sazon777z/RaceMetry/CODE_REVIEW.md

# Code review проекта RaceMetry / DRAGon

Дата ревью: 2026-08-29  
Ветка и ревизия: `master`, `9a54273`  
Состояние рабочего дерева до ревью: чистое

## 1. Резюме

Проект хорошо разделён на модули: GNSS, IMU, расчёт заезда, BLE, NVS, кнопка и LED не смешаны в одном файле. Для embedded-проекта удачно выбраны фиксированные буферы, бинарный UBX-парсер проверяет длину и checksum, а веб-интерфейс не зависит от внешних CDN.

При этом текущую версию нельзя считать готовой к достоверным спортивным замерам. Главные проблемы находятся не в оформлении, а в измерительном тракте:

- режим 1-Foot Rollout временно прекращает интегрировать дистанцию после прохождения первого фута;
- один и тот же GPS-пакет обрабатывается в цикле 200 Гц, из-за чего интерполяция скоростных отсечек фактически использует интервал около 5 мс вместо реального интервала GNSS 50 мс;
- при потере GPS последняя скорость продолжает интегрироваться, поэтому устройство способно «доехать» до дистанционной отсечки без новых координат и скорости;
- BLE-команды изменяют `TelemetryEngine`, `ImuEngine`, `StorageManager` и LED из callback-контекста одновременно с задачей телеметрии;
- веб-функции гаража, часового пояса и форматирования истории отсутствуют, хотя HTML их вызывает.

Рекомендуемый статус текущей ревизии: **не выпускать как измерительный релиз до исправления P0/P1 и стендовых тестов с воспроизведением записанного UBX-потока**.

| Уровень | Количество | Смысл |
|---|---:|---|
| P0 | 3 | Нарушает корректность основного результата заезда |
| P1 | 8 | Может портить данные, ломать функции или давать нестабильное поведение |
| P2 | 8 | Существенный функциональный/эксплуатационный долг |
| P3 | 5 | Документация, сопровождение и небольшие дефекты |

## 2. Что проверено

Просмотрены все исходники прошивки, оба HTML-клиента, Service Worker, манифест и документация. Проверены связи между командами веб-клиента, BLE-парсером и обработчиками прошивки, жизненный цикл заезда, сохранение истории, глубокий сон и восстановление GNSS.

Локальные проверки:

- `manifest.json` успешно разбирается как JSON;
- все ресурсы из `ASSETS_TO_CACHE` существуют;
- `index.html` и `dragon_app.html` имеют одинаковый SHA-256 и являются полными дубликатами;
- `git diff --check` не обнаружил проблем whitespace;
- в репозитории нет автоматических тестов;
- сборка не запускалась: в окружении отсутствуют `arduino-cli`/Arduino Builder;
- JavaScript syntax-check не запускался: Node.js отсутствует.

Последние два пункта важны: выводы ниже основаны на статическом анализе и трассировке потока данных, а не на подтверждённой сборке или испытании на железе.

## 3. Критические дефекты измерительного тракта (P0)

### P0-1. 1-Foot Rollout создаёт разрыв временной шкалы и теряет часть дистанции

**Где:** `TelemetryEngine.cpp:128-135`, `TelemetryEngine.cpp:153-171`, `TelemetryEngine.cpp:314-319`.

До прохождения первого фута `_prevTimeSec` отсчитывается от `_launchTimeUs`. При достижении 0.3048 м код меняет начало отсчёта на текущее `micros()` (`_rolloutTimeUs`), но не сбрасывает `_prevTimeSec` и предыдущую GPS-точку. На следующем вызове `currTimeSec` становится почти нулевым, а `_prevTimeSec` остаётся временем от старта. `dt` отрицателен, поэтому `_updateMeasuring()` выходит на строке 166.

Интеграция возобновляется лишь тогда, когда новая временная шкала догонит старое значение `_prevTimeSec`. Всё расстояние, реально пройденное машиной за этот промежуток, теряется. В результате дистанционные отсечки 60 ft, 1/8 и 1/4 мили срабатывают позже требуемой точки и дают завышенное время.

**Исправление:** разделить монотонную шкалу интеграции и отображаемое elapsed-time. Интеграция должна всегда использовать timestamp GNSS или непрерывный `micros()`. Rollout должен вычитать фиксированный временной offset из результата, не переопределяя время предыдущей выборки. Минимально допустимый вариант — при переходе в `MEASURING` переинициализировать `_prevTimeSec`, `_prevSpeed*`, `_prevDistM` согласованными значениями, но лучше не связывать интегратор с отображаемым временем вообще.

### P0-2. Скоростные отсечки интерполируются между псевдовыборками 200 Гц, а не между пакетами GNSS 20 Гц

**Где:** `DRAGon.ino:258-308`, `GpsEngine.cpp:184-299`, `TelemetryEngine.cpp:164-170`, `TelemetryEngine.cpp:187-244`.

`GpsEngine::update()` сообщает через возвращаемый `bool`, был ли получен новый PVT, но результат игнорируется. `telemetryEngine.process()` вызывается каждые 5 мс независимо от наличия нового GNSS-пакета. Между реальными пакетами одна и та же скорость обрабатывается около десяти раз, а `_prevTimeSec` обновляется каждый раз.

Когда приходит новая скорость, `_interpolateSpeedSplit()` получает предыдущую точку примерно за 5 мс, хотя реальная предыдущая GNSS-выборка была около 50 мс назад. Пересечение 60/100/200 км/ч помещается почти в момент прихода нового пакета, а не интерполируется по реальному интервалу измерений. Заявленная в README «субмиллисекундная точность» этим кодом не обеспечивается; возможна систематическая ошибка порядка почти одного GNSS-периода.

**Исправление:** запускать обновление GNSS-части `TelemetryEngine` только на новом валидном PVT и хранить timestamp этой выборки (`towMs` предпочтительнее времени доставки UART). IMU-триггер старта можно обслуживать отдельно на 200 Гц. Интерполяция скорости должна получать две реальные GNSS-точки.

### P0-3. При потере GNSS продолжается фиктивное движение с последней скоростью

**Где:** `TelemetryEngine.cpp:83-91`, `TelemetryEngine.cpp:168-171`, `DRAGon.ino:301-308`.

Во время заезда нет проверки `gps.validFix`, возраста `lastUpdateMs`, изменения `towMs` или результата `gpsEngine.update()`. Если UART/GNSS перестал отдавать данные на скорости, например, 100 км/ч, задача продолжит каждые 5 мс интегрировать сохранённые 100 км/ч. Устройство может самостоятельно достичь 402.336 м и сохранить правдоподобный, но полностью ложный результат.

**Исправление:** ввести политику качества данных. Новый расчёт дистанции допустим только по свежим GNSS-выборкам. При задержке выше согласованного порога (например, 2-3 периода PVT) заезд следует приостановить или перевести в `ABORTED` с причиной `GPS_STALE`; потерю 3D fix и недопустимый `sAcc` также нужно явно обрабатывать и передавать клиенту.

## 4. Высокий приоритет (P1)

### P1-1. `totalDurationSec` всегда сохраняется равным нулю

**Где:** `TelemetryEngine.cpp:74-80`, `TelemetryEngine.cpp:454-459`.

`_finalizeRun()` сначала устанавливает `_state = FINISHED`, а затем вызывает `getCurrentTimeSec()`. Getter возвращает 0 для любого состояния, кроме `MEASURING` и `LAUNCH_DETECTED`. Поэтому поле `dur` во всех BLE-записях равно нулю. Это повреждает карточки, синтетический график, экспорт и дедупликацию истории.

**Исправление:** вычислить elapsed-time до смены состояния либо сделать приватную функцию расчёта времени, не зависящую от `_state`.

### P1-2. BLE callback напрямую и конкурентно меняет состояние измерительных модулей

**Где:** `DRAGon.ino:162-225`, `DRAGon.ino:258-383`, `BleEngine.cpp:115-199`.

Обработчик `onWrite()` вызывается задачей BLE-стека, а не `TelemetryTask`. Из него без очереди и mutex вызываются:

- `telemetryEngine.arm/reset/setDiscipline/updateSettings()` одновременно с `process()`;
- `imuEngine.calibrateZero()` одновременно с `imuEngine.update()` на общей `Wire`;
- `storageManager.clearAllRuns()/getRunRecord()/saveSettings()` одновременно с `saveRunRecord()`;
- LED-анимации одновременно с `ledController.update()`;
- полный deep sleep из callback-контекста.

Особенно опасны `reset()`/`setDiscipline()`, поскольку они делают `memset` текущего результата во время его заполнения, и `calibrateZero()`, поскольку две задачи одновременно выполняют I2C-транзакции.

**Исправление:** callback должен только разобрать и положить типизированную команду в FreeRTOS queue. Все изменения телеметрии/IMU/LED выполнять в `TelemetryTask`; операции NVS и BLE-ответы — в одной выделенной задаче с определённым владельцем ресурсов.

### P1-3. Гонка `newRunSaved` может отправить старый или нулевой заезд

**Где:** `DRAGon.ino:360-380`, `DRAGon.ino:450-465`, `DRAGon.ino:483-489`.

`newRunSaved = true` выполняется вне `stateMutex`. До того как Core 0 скопирует `_lastRun` в `safeLastRun`, Core 1 может войти в critical section, увидеть флаг, скопировать старый `safeLastRun` и очистить флаг. После этого Core 0 уже не обновит `safeLastRun`, потому что условие `if (newRunSaved)` стало ложным.

Кроме того, `safeCurrentRun` нигде не заполняется, хотя копируется в `localCurr`.

**Исправление:** публиковать целый immutable snapshot и sequence number в одной critical section либо использовать очередь завершённых заездов. Флаг должен принадлежать тому же синхронизированному объекту, что и данные.

### P1-4. Передача BLE JSON не сериализована и использует общий `_txBuffer`

**Где:** `BleEngine.h:100-104`, `BleEngine.cpp:202-225`, `BleEngine.cpp:232-421`, `DRAGon.ino:205-224`, `DRAGon.ino:467-489`.

Live-телеметрия отправляется из `CommTask`, а история, `pong`, диагностика и info могут отправляться из BLE callback. Все функции форматируют данные в один `_txBuffer[512]` и вызывают notify без mutex/очереди. Два сообщения могут перезаписать буфер или чередовать 100-байтные фрагменты. Веб-клиент затем получает невалидный JSON и молча отбрасывает строку.

**Исправление:** единственный TX-owner и очередь готовых сообщений; либо mutex вокруг полного `snprintf + chunked notify`, но очередь лучше контролирует backpressure. Проверять результат отправки и ограничивать объём истории относительно пропускной способности соединения.

### P1-5. Веб-история и «Гараж» обращаются к отсутствующим функциям и переменным

**Где:** `index.html:1306-1309`, `index.html:1438`, `index.html:2697-2759`, `index.html:2919-2927`; те же строки в `dragon_app.html`.

В файле нет определений:

- `activeCarFilterId`;
- `openGarageModal()`;
- `getActiveCar()`;
- `renderCarFilters()`;
- `recalculatePersonalBestsForFilter()`;
- `formatRaceTimestamp()`.

Следствия: кнопки «Гараж» падают с `ReferenceError`, `renderHistoryList()` не работает, а блок инициализации обрывается внутри пустого `catch`. Если история уже есть в `localStorage`, исключение возникает ещё на строке 2888 и не выполняется дальнейшая инициализация настроек.

**Исправление:** либо полностью вернуть модель гаража и функции времени, либо удалить незавершённый UI и фильтрацию до отдельного релиза. Пустой `catch` заменить логированием и независимыми блоками инициализации.

### P1-6. IMU может объявляться исправной при отсутствии MPU или наличии другого I2C-устройства

**Где:** `ImuEngine.cpp:78-128`, `ImuEngine.cpp:133-164`.

Константа `MPU_REG_WHO_AM_I` объявлена, но не используется. Если адреса 0x68/0x69 не отвечают, код выбирает последний найденный адрес любого I2C-устройства. Если устройств нет, всё равно продолжает настройку 0x68. Результаты `_writeRegister()` игнорируются, `_isInitialized` безусловно становится `true`, а `begin()` возвращает `true`, даже когда тестовое чтение не удалось.

**Исправление:** принимать только ожидаемые значения `WHO_AM_I`, проверять каждую критичную запись/чтение и возвращать `false` при отсутствии подтверждённого MPU. Общий I2C scan оставить только диагностическим и никогда не использовать неизвестный адрес как IMU.

### P1-7. `gpsEngine.wakeUp()` при старте гарантированно ничего не делает

**Где:** `DRAGon.ino:152-155`, `GpsEngine.cpp:23-24`, `GpsEngine.cpp:579-587`.

`wakeUp()` вызывается до `begin()`, когда `_serial == nullptr`, поэтому сразу возвращается. После собственного `powerOff()` GNSS находится в backup mode с пробуждением по UART RX. Auto-baud сначала только слушает несколько скоростей и не посылает wake-последовательность. В итоге восстановление после deep sleep зависит от случайного пробуждения первыми байтами конфигурационной команды; начало самой команды может быть потеряно.

**Исправление:** передать/инициализировать UART до wake-up либо перенести wake-последовательность внутрь `begin()`, затем выдержать datasheet delay и только после этого выполнять валидируемый auto-baud.

### P1-8. У всех заездов `id == 0`, а веб-дедупликация может удалять разные результаты

**Где:** `Types.h:105`, `TelemetryEngine.cpp:55-60`, `StorageManager.cpp:60-75`, `index.html:2558-2564`.

Поле `RunRecord.id` нигде не присваивается. Одновременно дефект P1-1 делает `dur == 0`. Веб-клиент считает записи одинаковыми, если совпали `id` и timestamp. Два заезда в одну UTC-секунду имеют одинаковые `id=0` и `ts`, поэтому второй не попадёт в локальную историю.

**Исправление:** хранить в NVS монотонный `nextRunId` (лучше 64-bit либо boot-id + sequence), присваивать его до записи и дедуплицировать строго по нему. Timestamp не должен быть идентификатором.

## 5. Средний приоритет (P2)

### P2-1. Прошивка никогда не отправляет события отсечек

**Где:** `BleEngine.cpp:297-309`, `DRAGon.ino:327-330`, `index.html:2128-2131`, `index.html:2534-2547`.

`sendSplitEvent()` реализован, веб-клиент умеет озвучивать пакет `t=split`, но вызовов `sendSplitEvent()` в проекте нет. `checkAndClearSplitTrigger()` управляет только LED. Заявленные голосовые/звуковые уведомления 60/100/200 км/ч не работают.

Нужно публиковать конкретный тип новой отсечки и её значения, а не один общий `bool`, и отправлять событие через TX-очередь.

### P2-2. Синхронизация истории выполняется дважды и заканчивается показом самого старого заезда

**Где:** `DRAGon.ino:416-433`, `index.html:2046-2056`, `index.html:2549-2569`, `StorageManager.cpp:82-92`.

Прошивка сама отправляет всю историю при подключении, а веб-клиент через 800 мс повторно посылает `get_history`. `getRunRecord(0)` возвращает самый новый заезд, далее идут старые; `handleRunFinished()` каждый пакет делает текущим. После синхронизации `lastRunData` указывает на самый старый заезд, и каждый исторический пакет способен запускать toast/звук «финиш».

Следует выбрать один handshake: клиент явно запрашивает историю, сервер отвечает пакетами с `history_begin/history_end`, а UI не трактует их как только что завершившийся заезд.

### P2-3. Графики разных заездов смешиваются

**Где:** `index.html:1692`, `index.html:2477-2480`, `index.html:2549-2556`, `index.html:2664-2669`.

`currentRunSamples` очищается только при смене дисциплины. Нажатие Arm и завершение заезда буфер не сбрасывают. Следующий run получает точки всех предыдущих заездов текущей дисциплины.

Очищать буфер при подтверждённом переходе `IDLE/FINISHED -> ARMED` и после привязки samples к завершённому run.

### P2-4. Хранилище не проверяет ошибки и не имеет версии схемы

**Где:** `StorageManager.cpp:9-16`, `StorageManager.cpp:46-57`, `StorageManager.cpp:60-75`, `DRAGon.ino:120-123`, `DRAGon.ino:553-572`.

Результат `storageManager.begin()` игнорируется, `saveSettings()` всегда возвращает `true`, результаты `put*` не проверяются, а диагностика жёстко задаёт `storageOk = true`. `RunRecord` сохраняется как raw bytes C++-структуры без magic/schema version/CRC. Любое изменение полей, padding или enum способно сделать старые записи несовместимыми без явного обнаружения.

Нужны проверяемые возвраты, версия формата, размер, CRC и миграция/инвалидация старых записей. Диагностика должна выполнять реальную безопасную read/write-проверку или хотя бы отражать статус `begin()` и последней операции.

### P2-5. Очистка истории не очищает Personal Bests

**Где:** `StorageManager.cpp:95-105`, `StorageManager.cpp:107-160`, `index.html:2684-2694`.

Команда называется `clear_history`, UI сообщает «Память заездов очищена», но ключи `pb_*` остаются. После очистки пользователь продолжит видеть рекорды, которых уже нет в истории.

Следует либо очищать PB вместе с историей, либо разделить команды и явно назвать поведение в UI.

### P2-6. Калибровка IMU делит сумму на число запрошенных, а не успешных чтений

**Где:** `ImuEngine.cpp:233-255`.

Ошибочные I2C-чтения пропускаются, но знаменатель всегда `sampleCount`. Несколько сбоев уменьшают offset, а ноль успешных чтений всё равно помечает IMU как calibrated. Нужен счётчик успешных выборок, минимальный процент успеха и возврат результата калибровки.

### P2-7. Критерий готовности в NMEA fallback не гарантирует 3D fix

**Где:** `GpsEngine.cpp:478-547`, `GpsEngine.cpp:550-552`, `DRAGon.ino:165-173`.

RMC со статусом `A` и GGA с quality >= 1 устанавливают `validFix=true`, а `isReadyForRace()` не проверяет `fixType == 3/4`. После сохранённых данных о спутниках прошивка может принять `arm` без 3D fix. В UBX режиме fix 4 разрешён прошивкой, но веб UI распознаёт только fix 3 (`index.html:2334-2337`, `index.html:2491-2501`), поэтому стороны также расходятся.

Нужна единая нормализованная модель качества фикса независимо от источника UBX/NMEA.

### P2-8. BLE разрешает опасные команды без аутентификации

**Где:** `BleEngine.cpp:20-83`, `DRAGon.ino:162-225`.

Сервис не использует bonding/passkey/авторизацию приложения, но принимает `clear_history`, `calibrate_imu` и `power_off`. Для одиночного домашнего устройства это может быть приемлемой моделью угроз, однако на соревнованиях ближайший клиент способен подключиться первым и изменить состояние или стереть историю.

Минимум: документировать модель угроз и запрещать destructive-команды во время активного заезда. Для реального продукта — pairing/bonding и подтверждение опасных операций физической кнопкой.

## 6. Низкий приоритет и сопровождаемость (P3)

### P3-1. Настройка часового пояса отсутствует

**Где:** `index.html:1452-1464`, `index.html:2577`, `index.html:2915-2917`.

HTML вызывает отсутствующую `setTimezoneSetting()`, а карточка всегда использует системный `toLocaleString()`. Выбор не сохраняется и не применяется. Реализовать сохранение `racemetry_tz` и единый `formatRaceTimestamp()` либо убрать контрол.

### P3-2. RSSI всегда фиктивный

**Где:** `BleEngine.cpp:3`, `BleEngine.cpp:99-112`, `BleEngine.cpp:291`, `index.html:2214-2266`.

`s_latestRssi` принимает только -55 при connect и -99 при disconnect; фактического чтения RSSI нет. UI показывает качество сигнала как реальное. До реализации измерения лучше передавать `null`/неизвестно.

### P3-3. Offline fallback Service Worker написан неверно

**Где:** `sw.js:45-49`.

`caches.match(event.request) || caches.match('./index.html')` не выполняет второй вариант, поскольку первый вызов сразу возвращает truthy Promise, даже если итоговое значение Promise будет `undefined`. Нужен `caches.match(event.request).then(r => r || caches.match('./index.html'))`.

### P3-4. Два HTML-файла — идентичные копии

`index.html` и `dragon_app.html` имеют одинаковый SHA-256. Любая будущая ручная правка только одного файла создаст труднообнаружимое расхождение. Оставить один canonical entry point, второй генерировать/копировать в сборке или сделать redirect-обёрткой.

### P3-5. Документация заметно расходится с кодом

Примеры:

- `README.md:73` предлагает выбрать `DRAGon-Telemetry`, а прошивка рекламирует `RaceMetry-Pro` (`Config.h:54`);
- `USER_MANUAL.md:24` заявляет цикл 500 Гц/2 мс, фактически `DRAGon.ino:260` задаёт 5 мс/200 Гц;
- `USER_MANUAL.md:26` говорит о допуске ±1%, а код разрешает любой положительный уклон и запрещает только downhill ниже настройки (`TelemetryEngine.cpp:471-472`);
- `USER_MANUAL.md:128-131` перечисляет отдельную 1/8 мили и Custom, которых нет в `RaceDiscipline` и UI;
- README обещает динамические BLE-отсечки и графики, но split-пакеты не отправляются, а сохранённые в NVS заезды не содержат samples;
- комментарии GPS по-прежнему местами говорят о 18 Гц (`GpsEngine.cpp:58`, `GpsEngine.cpp:98`, `GpsEngine.cpp:111-126`) при конфигурации 20 Гц.

Документацию следует генерировать/проверять по единой таблице возможностей перед релизом.

## 7. Дополнительные наблюдения

- `_splitTriggered`, `_timeAt200KmhSec` и часть полей не инициализируются явно в конструкторе/reset. Глобальный экземпляр сейчас получает zero-initialization до конструктора, но класс становится небезопасным для локального/динамического создания. Все поля нужно явно инициализировать и сбрасывать в `arm()`.
- `_finalizeRun()` берёт `finishAltM` из `_prevAltM`, то есть из точки до текущего пересечения. Для slope корректнее интерполировать высоту в той же точке, где достигнута финишная дистанция.
- Auto-baud считает любую последовательность более пяти байт доказательством правильной скорости (`GpsEngine.cpp:38-53`). Шум или декодирование на неверном baud могут дать false positive; следует подтверждать корректный UBX checksum/NMEA checksum.
- При 40 I2C-ошибках `ImuEngine::update()` синхронно запускает полный `begin()` со scan и многочисленными delay (`ImuEngine.cpp:166-174`). Это может надолго остановить высокоприоритетную задачу посреди заезда. Реинициализацию нужно выполнять только вне измерения или завершать заезд с аппаратной ошибкой.
- `clearHistory()` в вебе не `await`-ит `sendBleCmd()`: при отсутствии связи локальная история всё равно очищается и показывается успешный toast (`index.html:2684-2694`).
- При будущей реализации автомобильных фильтров `renderHistoryList()` передаёт индекс массива `filtered`, но `viewHistoricalRun()` индексирует исходный `savedRuns` (`index.html:2715-2736`, `index.html:2753-2755`). Будет открываться другой заезд.
- Константы `STOP_TIME_STABLE_MS`, `MAX_RUN_SAMPLES`, `SLOPE_TOLERANCE_WINDOW`, `BTN_HOLD_POWER_ON_MS`, `GPS_BAUDRATE_INITIAL` и тип `TelemetrySample` фактически не используются. Это создаёт ложное впечатление реализованных функций.
- `DisplayEngine.h/.cpp` являются пустыми compatibility-файлами и нигде не используются. Их назначение лучше явно описать в README либо удалить после проверки Arduino IDE.

## 8. Что сделано хорошо

- Чёткие границы модулей и понятные имена публичных методов.
- UBX state machine проверяет checksum и не пишет payload за пределы 512-байтного буфера.
- При разборе чисел для BLE выполняются проверки NaN/Inf.
- NVS-история организована как ограниченное кольцо, поэтому объём не растёт бесконтрольно.
- Веб-клиент аккумулирует фрагменты BLE до newline и не предполагает, что один notify равен одному JSON.
- PWA-ресурсы локальны; базовая offline-установка не зависит от стороннего хостинга библиотек.
- Батарея фильтруется как на уровне сырых выборок, так и EMA; крайние ADC-выбросы исключаются.
- Для deep sleep предусмотрено отпускание кнопки перед включением wakeup, что снижает риск немедленного пробуждения.

## 9. Рекомендуемый порядок исправлений

1. Написать детерминированные host-тесты `TelemetryEngine` с подменяемым clock и потоком GNSS ровно 20 Гц.
2. Разделить 200-Гц IMU processing и обработку только новых GNSS epochs; добавить stale/fix abort.
3. Исправить rollout и `totalDurationSec`; тестами закрыть 0-60, 0-100, 100-200, 402 м, rollout on/off и brake.
4. Ввести очереди `BleCommandQueue`, `BleTxQueue` и очередь завершённых runs; назначить одному task владельца каждого изменяемого модуля.
5. Исправить определение IMU и сценарий wake/reconfigure GNSS.
6. Добавить уникальные run IDs и версионированный формат NVS.
7. Восстановить или убрать незавершённые Garage/Timezone-функции; разделить live run и history sync.
8. После этого провести HIL-тест: записанный UBX 20 Гц + аппаратный IMU, отключение UART в середине заезда, BLE-команды во время измерения, переподключение и заполненное кольцо из 20 записей.
9. Настроить CI: компиляция ESP32-S3 для зафиксированной версии Arduino-ESP32, host unit tests, JS lint/syntax check, проверка manifest/service-worker assets.

## 10. Минимальный набор обязательных тестов перед релизом

| Тест | Ожидаемое поведение |
|---|---|
| Линейный разгон, GNSS 20 Гц | Отсечки интерполируются между двумя реальными PVT epoch |
| Тот же разгон, rollout OFF/ON | Разность только в корректно рассчитанном rollout offset; финишная дистанция не «замерзает» |
| Потеря UART на 100 км/ч | Заезд становится `ABORTED/GPS_STALE`, дистанция больше не растёт |
| Потеря 3D fix / рост `sAcc` | Результат не сохраняется как валидный без явной причины |
| Finish каждой дисциплины | `dur > 0`, нужная split достигнута, ненужные не влияют на completion |
| Два заезда в одну секунду | Два разных ID, обе записи остаются в NVS и браузере |
| Reset/set_disc во время run | Команда обрабатывается последовательно, без частично записанного RunRecord |
| Calibrate во время run | Команда отклонена/отложена, I2C не используется двумя задачами |
| BLE history + live 15 Гц | JSON не перемешивается, есть begin/end, порядок явно определён |
| NVS от старой версии | Запись мигрирует либо безопасно отклоняется по schema/CRC |
| Offline navigation на неизвестный URL | Service Worker возвращает cached `index.html` |
| Web smoke test | Нет `ReferenceError`; Garage/Timezone либо работают, либо отсутствуют в UI |

## 11. Итог

Архитектурный каркас проекта перспективный, но качество измерительного результата сейчас подрывают ошибки временной шкалы, отсутствие привязки к новым GNSS epochs и отсутствие обработки stale GPS. Параллельно межзадачные обращения к одним объектам делают поведение недетерминированным, а незавершённый Garage/Timezone-код ломает историю веб-приложения.

Сначала следует стабилизировать измерительное ядро и модель конкурентности, затем чинить синхронизацию/историю UI. Косметическая полировка до этого даст мало пользы: основные риски находятся в корректности результата и целостности данных.
