sazon777z/RaceMetry/USER_MANUAL.md

# 🏎️ RaceMetry / DRAGon Pro Telemetry — Руководство пользователя

Профессиональный высокоточный 20 Гц гоночный измерительный комплекс на базе микроконтроллера **ESP32-S3**, спутникового модуля **u-blox M10Q (20 Гц UBX)**, 6-осевого датчика ускорений и наклона **InvenSense MPU-9250** и прогрессивного веб-приложения **RaceMetry Web App (Bluetooth Low Energy)**.

---

## 📋 Содержание
1. [Основные возможности и характеристики](#1-основные-возможности-и-характеристики)
2. [Схема подключения и распиновка (Pinout)](#2-схема-подключения-и-распиновка-pinout)
3. [Физическое управление кнопкой](#3-физическое-управление-кнопкой)
4. [Светодиодная индикация (LED Guide)](#4-светодиодная-индикация-led-guide)
5. [Веб-приложение RaceMetry (PWA)](#5-веб-приложение-racemetry-pwa)
6. [Звуковое сопровождение и голосовой штурман](#6-звуковое-сопровождение-и-голосовой-штурман)
7. [Дисциплины замеров и правила валидности](#7-дисциплины-замеров-и-правила-валидности)
8. [Режим прозрачного моста для u-center](#8-режим-прозрачного-моста-для-u-center)
9. [Рекомендации по установке в автомобиле](#9-рекомендации-по-установке-в-автомобиле)

---

## 1. Основные возможности и характеристики

* **Сверхвысокая частота навигации 20 Гц**: GPS/GNSS модуль u-blox M10Q опрашивается 20 раз в секунду по скоростному бинарному протоколу UBX (460 800 бод), обеспечивая дискретность замера 50 миллисекунд.
* **Двухъядерная архитектура FreeRTOS**:
  * **Ядро 0 (Core 0)**: Скоростной цикл 500 Гц (2 мс) — непрерывный разбор UBX-пакетов, математическая интерполяция отсечек, 200 Гц опрос акселерометра MPU-9250, антидребезг кнопки и управление светодиодом.
  * **Ядро 1 (Core 1)**: Беспроводной стек BLE 5.0 (Nordic UART Service, 15 Гц live-телеметрия), фильтрация АЦП батареи и синхронизация с NVS памятью.
* **Анализ уклона трассы (Slope Control)**: Автоматический расчет среднего и пикового уклона трассы на отрезке заезда по международному стандарту (валидный заезд при уклоне не более ±1.00%).
* **1-Foot Rollout**: Опция замера по регламенту NHRA/американских драг-стрипов (списание первых 30.48 см движения).
* **Автономная энергонезависимая память NVS**: Запись лучших результатов (Personal Bests) и последних заездов прямо в чип ESP32 без риска потери данных при выключении.
* **100% Офлайн-приложение PWA**: Работает прямо в браузере без установки из Google Play / App Store и не требует интернета на треке.

---

## 2. Схема подключения и распиновка (Pinout)

Схема построена на базе внешнего модуля питания **MH-CD42 (5V Boost + Li-Ion Charger)**, питающего всю схему стабилизированным напряжением 5.0V и исключающего перегрев и выгорание диодов на ESP32:

| Компонент / Функция | Пин ESP32-S3 | Куда подключается / Примечание |
|---|---|---|
| **Питание 5V** | `5V (VIN)` | К выходу `OUT 5V` модуля питания MH-CD42. |
| **Общая земля (GND)** | `GND` | К выводу `GND` модуля MH-CD42 и всем датчикам. |
| **Адресный RGB LED (WS2812B)** | `GPIO 10` | Линия данных DIN. Питание LED берется с шины 5V MH-CD42. |
| **GPS u-blox M10Q (RX прибора)** | `GPIO 44` | Подключается к пину **TX** модуля GPS. |
| **GPS u-blox M10Q (TX прибора)** | `GPIO 43` | Подключается к пину **RX** модуля GPS. |
| **Акселерометр / IMU (SDA)** | `GPIO 12` | Линия данных шины I2C (400 кГц). |
| **Акселерометр / IMU (SCL)** | `GPIO 13` | Линия тактирования шины I2C. Питание IMU — 3.3V. |
| **АЦП делителя аккумулятора** | `GPIO 1` | Средняя точка делителя 1:2 (220к + 220к), подключенного к силовому контакту `BAT +` платы MH-CD42. Рекомендуется конденсатор **100 нФ** между GPIO 1 и GND. |
| **Кнопка управления (опция)** | `GPIO 11` | Подключается к `GND` для опроса батареи двойным кликом. |

---

## 3. Физическое управление питанием и кнопкой

В приборе используется продуманная гибридная схема управления питанием:

### 1. Силовое управление через модуль MH-CD42:
* **Кнопка на корпусе** подключается к выводу **`KEY`** (и `GND`) на плате MH-CD42.
* ⚡ **Включение (Power ON)**: **1 короткий клик** по кнопке -> MH-CD42 мгновенно подает стабилизированные 5.0V на плату ESP32-S3 и датчики.
* 🔌 **Полное выключение (Power OFF)**: **2 быстрых клика** (Double Click) по кнопке -> MH-CD42 полностью обесточивает шину 5.0V (нулевой ток утечки 0 мкА, аккумулятор не садится при длительном хранении).
* 🔋 **Встроенная индикация**: 4 светодиода на самой плате MH-CD42 наглядно информируют об уровне заряда аккумулятора (25% / 50% / 75% / 100%) и статусе зарядки по USB Type-C.

### 2. Управление через микроконтроллер (если кнопка подключена к GPIO 11):
| Действие | Как выполнить | Что происходит |
|---|---|---|
| 🔋 **Проверка батареи по WS2812** | Быстрый **двойной клик** (Double Click) | Светодиод на 2.5 сек показывает заряд АКБ цветом или серией вспышек. |
| 💤 **Программный Deep Sleep** | Нажать и удерживать **1.5 сек** | Перевод ESP32 и GPS в режим глубокого сна. |

---

## 4. Светодиодная индикация (LED Guide)

Яркость светодиода настроена для максимального комфорта: мягкое фоновое свечение в движении (не слепит водителя ночью) и мгновенные яркие вспышки при ключевых событиях заезда.

```
[Поиск GPS]      -> Мягкое тусклое мерцание СИНИМ (Дыхание)
[GPS пойман]     -> Двойная зеленая вспышка -> Ровный ТУСКЛЫЙ ЗЕЛЕНЫЙ
[Старт (Launch)] -> ЯРКАЯ БЕЛО-ЗЕЛЕНАЯ ВСПЫШКА (110 мс)
[Отсечки 60/100] -> ЯРКАЯ БЕЛО-ЗЕЛЕНАЯ ВСПЫШКА (110 мс на каждой отсечке)
[Финиш Valid]    -> 3 ЯРКИХ ЗЕЛЕНЫХ ВСПЫШКИ -> Возврат в тусклый зеленый
[Финиш Невалиден]-> 3 ЯРКИХ ОРАНЖЕВЫХ ВСПЫШКИ -> Возврат в тусклый зеленый
[Выключение]     -> Обратный отсчет (желтый->красный) -> 2 КРАСНЫХ ВСПЫШКИ (под пальцем) -> Отпускаем кнопку
```

### Режимы проверки заряда батареи (по двойному клику):
* **Режим 1: «Градация цветами»** (непрерывное свечение 2.5 сек):
  * 🟢 **Зеленый**: Заряд $\ge 80\%$
  * 🟡 **Желтый / Золотой**: Заряд $40\% .. 79\%$
  * 🟠 **Оранжевый**: Заряд $20\% .. 39\%$
  * 🔴 **Частое мигание красным**: Заряд $< 20\%$ (требуется зарядка)
* **Режим 2: «Серия вспышек»**:
  * 🟢 **4 зеленые вспышки**: $\ge 80\%$
  * 🟢 **3 зеленые вспышки**: $50\% .. 79\%$
  * 🟡 **2 желтые вспышки**: $25\% .. 49\%$
  * 🔴 **1 красная вспышка**: $< 25\%$

---

## 5. Веб-приложение RaceMetry (PWA)

Для подключения не требуются приложения из магазинов — интерфейс работает через стандартный **Web Bluetooth API**:

1. Откройте страницу `index.html` (или GitHub Pages адрес) в браузере **Google Chrome** или **Яндекс.Браузер** (на Android/ПК) либо через браузер **Bluefy** (на iOS);
2. Нажмите большую кнопку **«Подключить BLE»** в верхней части экрана;
3. В появившемся окне выберите устройство **`RaceMetry-Pro`** и нажмите *«Подключить»*;
4. Приложение мгновенно синхронизирует время, рекорды, заряд аккумулятора и состояние спутников.

> **💡 Работа без интернета:** Приложение сохраняется в кэш браузера (*Service Worker*). Вы можете добавить его на главный экран телефона (*«Установить на экран “Домой”»*) и пользоваться им в полевых условиях без интернета.

---

## 6. Звуковое сопровождение и голосовой штурман

В меню «Настройки» доступен выбор 4 аудиорежимов:

1. 🔇 **«Без звука»** (по умолчанию) — бесшумный режим.
2. 🔊 **«Сигналы»** — профессиональные высокочастотные синтезированные бипы (как в Dragy):
   * **Двойной чирп (Ready)**: Готов к старту;
   * **Короткий пинг (Launch)**: Обнаружен старт;
   * **Чистый тон (Split)**: Пройдена отсечка (60, 100, 200 км/ч);
   * **Победный мажорный аккорд**: Успешный валидный финиш;
   * **Низкий зуммер**: Невалидный заезд (превышен уклон).
3. 🗣️ **«Голосовая озвучка»** — штурман озвучивает статус («Готов к старту», «Старт», время на отсечках и финише). Доступно 5 профилей тембра:
   * 🏆 *Спортивный штурман*;
   * 📡 *Четкая телеметрия*;
   * 🎙️ *Классический диктор*;
   * 🔊 *Глубокий бас*;
   * ⚡ *Быстрый трек*.
4. ⚡ **«Сигналы + Голосовая озвучка»** — одновременная подача мгновенного звукового бипа и последующая голосовая озвучка времени.

---

## 7. Дисциплины замеров и правила валидности

В приложении доступны стандартные и кастомные гоночные дисциплины:
* 🏎️ **0–100 км/ч** (с промежуточной отсечкой 0–60 км/ч);
* 🚀 **100–200 км/ч** (с отсечкой 100–150 км/ч);
* ⚡ **0–200 км/ч** (с отсечками 0–60, 0–100, 100–200);
* 🏁 **1/4 мили (402.33 м)** (с отсечками 60 футов, 330 футов, 1/8 мили, 1000 футов и скоростью на выходе);
* 🏁 **1/8 мили (201.17 м)**;
* 🏁 **1/2 мили (804.67 м)**;
* 🛑 **100–0 км/ч (Торможение)** — замер тормозного пути в метрах и времени замедления;
* ⏱️ **Пользовательский заезд (Custom)** — настраиваемые диапазоны скорости и дистанции.

### Автоматический запуск заезда:
1. Остановите автомобиль (скорость $< 1.0$ км/ч);
2. При наличии 3D-фикса плашка состояния загорится зеленым: **«ГОТОВ К СТАРТУ»**;
3. Начните резкое ускорение — прибор автоматически зафиксирует старт по датчику перегрузки и GPS;
4. После достижения целевой скорости или дистанции заезд автоматически завершится и сохранится в память.

---

## 8. Режим прозрачного моста для u-center

В прошивке предусмотрен режим сквозного USB-моста для прямой работы с GPS-модулем через официальную утилиту **u-blox u-center / u-center 2**:

1. В файле `Config.h` установите:
   ```cpp
   #define GPS_BRIDGE_MODE true
   ```
2. Загрузите скетч в ESP32-S3 через Arduino IDE;
3. Светодиод загорится **неоновым голубым цветом**;
4. Откройте u-center на ПК, выберите COM-порт ESP32 (скорость 115200) — вы получите прямой доступ к конфигурации чипсета M10Q, просмотру созвездий спутников и обновлению прошивки GPS.

---

## 9. Рекомендации по установке в автомобиле

1. **Расположение антенны**: Закрепляйте прибор керамической антенной GPS строго **вверх к небу** на передней панели под лобовым стеклом автомобиля (в зоне без нитей электрообогрева или атермального напыления).
2. **Фиксация корпуса**: Прибор должен быть неподвижно зафиксирован (на двухсторонний скотч или нескользящий коврик), чтобы акселерометр корректно отслеживал продольное ускорение $G_x$.
3. **Калибровка горизонта (IMU Zero)**: При первой установке поставьте автомобиль на горизонтальную ровную площадку и нажмите кнопку **«Калибровать 0G»** в Настройках приложения.
4. **Хранение аккумулятора**: Не оставляйте прибор под прямыми солнечными лучами на раскаленной парковке летом. Заряжайте аккумулятор стандартным током 5V Type-C.

---
*RaceMetry Telemetry System — Разработано для автоспорта и энтузиастов тюнинга.*
