sazon777z/RaceMetry/ImuEngine.h

#pragma once
#include <Arduino.h>
#include <Wire.h>
#include "Config.h"
#include "Types.h"

/**
 * ============================================================================
 *                          RACEMETRY TELEMETRY METER
 *                    IMU ENGINE (MPU-9250 / MPU-6500 / MPU-6050)
 * ============================================================================
 * Драйвер скоростного опроса акселерометра и гироскопа (200 Гц).
 * Отвечает за:
 * - Мгновенную фиксацию старта (Launch Jerk Trigger < 1 мс)
 * - Расчет перегрузок (G-Force) во всех плоскостях
 * - Калибровку нуля и фильтрацию вибраций двигателя
 * - Автоматическое сканирование и авто-определение пинов шины I2C
 */

class ImuEngine {
public:
    ImuEngine();

    // Инициализация I2C шины и автоопределение MPU-9250 / MPU-6500 / MPU-6050 / ICM
    bool begin(uint8_t sdaPin = PIN_I2C_SDA, uint8_t sclPin = PIN_I2C_SCL, uint32_t freq = I2C_FREQUENCY);

    // Повторная инициализация / поиск датчика на шине
    bool reinit();

    // Опрос датчика (вызывать в скоростном цикле 200 Гц)
    bool update();

    // Калибровка нуля (возвращает true при успешном сборе достаточного числа выборок)
    bool calibrateZero(uint16_t sampleCount = 500);

    // Установка калибровочных оффсетов из NVS
    void setOffsets(float axOffset, float ayOffset, float azOffset);
    void getOffsets(float& axOffset, float& ayOffset, float& azOffset) const;

    // Сброс пиковых значений G
    void resetPeaks();

    // Получить текущие данные и сэмпл
    const ImuData& getData() const { return _data; }
    ImuSample getLatestSample() const;

    // Проверка готовности датчика
    bool isReady() const { return _isInitialized; }

    // Проверка, есть ли резкий рывок вперед (старт)
    bool isLaunchDetected() const;

    // Диагностические методы
    const char* getStatusMessage() const { return _statusMsg; }
    uint8_t getWhoAmI() const { return _whoAmI; }
    uint8_t getDetectedI2cAddress() const { return _i2cAddr; }
    uint8_t getActiveSdaPin() const { return _sdaPin; }
    uint8_t getActiveSclPin() const { return _sclPin; }

private:
    bool _isInitialized;
    uint8_t _i2cAddr;
    uint8_t _whoAmI;
    char _statusMsg[80];
    ImuData _data;

    float _offsetX;
    float _offsetY;
    float _offsetZ;

    // Коэффициент чувствительности (для диапазона ±4G -> 8192.0 LSB/g)
    const float ACCEL_SCALE = 8192.0f;
    const float GYRO_SCALE = 65.5f; // для диапазона ±500 deg/s

    // Экспоненциальный фильтр скользящего среднего
    float _filtAx;
    float _filtAy;
    float _filtAz;

    uint8_t  _sdaPin;
    uint8_t  _sclPin;
    uint32_t _freq;
    uint16_t _errorCount;

    void _recoverI2cBus(uint8_t sda, uint8_t scl);
    bool _writeRegister(uint8_t reg, uint8_t value);
    bool _readRegisters(uint8_t reg, uint8_t* buffer, uint8_t length);
    uint8_t _probeWhoAmI(uint8_t addr);
};
