sazon777z/RaceMetry/(commit log)

2026-08-25 Реализация профессионального измерителя динамики DRAGon на ESP32-S3
2026-08-25 Обновление конфигурации пинов дисплея GPIO 1-6 и периферии
2026-08-25 Настройка аппаратных пинов UART RX/TX для модуля GPS u-blox M10Q
2026-08-25 Обновление пинов I2C акселерометра MPU-9250 на SCL=12 и SDA=13
2026-08-25 Обновление пинов кнопок управления на GPIO 10 и GPIO 9
2026-08-25 Исправление ошибки компиляции: добавлен метод isLaunchDetected в ImuData
    [Types.h]
2026-08-25 Исправление геометрии GRAM ST7789 и артефактов шума на 1.47 дюймовом IPS дисплее
2026-08-25 Устранение наложений текста в статус-баре и оптимизация верстки под скругленные углы IPS 1.47
2026-08-25 Реализация автоопределения скорости UART и гибридного разбора UBX/NMEA для GPS M10Q
2026-08-25 Разгон u-blox M10Q до максимальной частоты 18 Гц (55 мс) на скорости 460800 бод
2026-08-25 Добавлен режим прозрачного аппаратного USB-моста с программой u-blox U-Center
2026-08-25 Реализация прямого прозрачного USB-моста без текстового логгирования для u-center 2
2026-08-25 Оптимизация блочного USB-моста без задержек и добавление ручного выбора скорости UART кнопкой 10
2026-08-25 Реализация профессионального спортивного интерфейса в стиле RaceLogic/Dragy, расширенной телеметрии и экрана личных рекордов
2026-08-25 Реализация динамической световой хореографии WS2812B: поиск спутников синим, готовность зеленым, стробоскопы отсечек и победные вспышки
2026-08-25 Исправление компиляции: закрывающая скобка в StorageManager и добавление псевдонима RUNNING в LedMode
    [LedController.h, StorageManager.cpp]
2026-08-25 Исправление управления адресным светодиодом WS2812B через прямой вызов neopixelWrite
    [LedController.cpp]
2026-08-25 Переход на безэкранную BLE архитектуру (Nordic UART Service) и интеграция веб-приложения DRAGon
2026-08-25 Добавление пустых файлов-заглушек DisplayEngine для совместимости с открытыми вкладками Arduino IDE
2026-08-25 Улучшение стабильности BLE GATT подключения на Android устройствах
2026-08-25 Добавление мониторинга напряжения и процента заряда аккумулятора в прошивку и веб-интерфейс
2026-08-25 Перевод кнопки на GPIO 11 (клик/двойной клик/удержание), перенос светодиода на плату ESP32 и обновление виджета батареи
2026-08-25 Добавление самодиагностики оборудования при подключении и перевод GPS на 20 Гц
2026-08-25 Улучшение отображения виджета батареи и статуса питания в веб-приложении
2026-08-25 Перевод кнопки на GPIO 11 исключительно для функции включения и выключения (Deep Sleep) со световой индикацией
2026-08-25 Официальный ребрендинг проекта в RaceMetry Pro (BLE-имя RaceMetry-Pro, 20 Гц)
2026-08-25 Исправление области видимости переменной curState в основном цикле телеметрии
    [DRAGon.ino]
2026-08-25 Перенос виджета батареи в верхнюю строку рядом с кнопкой подключения и оптимизация статус-бара
2026-08-25 Улучшение прозрачного моста U-Center с авто-определением скорости и диагностикой в Serial
2026-08-25 Финальная корректировка лога запуска под бренд RaceMetry
2026-08-25 Включение и оптимизация режима моста u-center 2 с нулевой задержкой
2026-08-25 Возврат боевого режима 20 Гц телеметрии RaceMetry Pro (GPS_BRIDGE_MODE false)
2026-08-25 Исправление сжатия переключателя 1-foot rollout и верстки бегунка в настройках
2026-08-27 Добавлена вкладка детального монитора GPS, сглаживание спидометра, дисциплина 0-60, исправление сохранения заездов и верстки G-метра
    [BleEngine.cpp, DRAGon.ino, GpsEngine.cpp, GpsEngine.h, StorageManager.cpp, TelemetryEngine.cpp, Types.h]
2026-08-27 Исправлена логика включения и выключения кнопкой: RTC подтяжка, фиксация пина и защита от ложного старта при отпускании
    [DRAGon.ino]
2026-08-27 Настройка АЦП ADC_11db для замера батареи с делителем 2x220k, переименование вкладки Графики и статус Поиск GPS до 3D-фикса
2026-08-27 Добавлено отображение уровня сигнала связи Bluetooth (RSSI) рядом со значком батареи
2026-08-27 Реализовано программное усыпление и пробуждение GPS модуля u-blox M10Q по UBX-RXM-PMREQ (Backup mode 15 мкА)
2026-08-27 Удален низкоуровневый заголовок esp_gap_ble_api.h для полной совместимости с Arduino IDE ESP32 v3.3.x
2026-08-27 Синхронизированы размеры виджетов батареи и сигнала связи, добавлено мгновенное отображение при подключении
2026-08-27 Улучшен драйвер IMU MPU-9250: добавлено восстановление шины I2C, авто-сканирование адресов 0x68/0x69 и надежное пробуждение из сна
2026-08-27 Убран текст dBm из шапки приложения, оставлена компактная 4-сегментная шкала уровня связи (как в iOS/Android)
2026-08-27 Упрощена и восстановлена надежная инициализация акселерометра MPU без блокирующих проверок WhoAmI
2026-08-27 Добавлено авто-определение пинов I2C (13/12 и 12/13), полный сканер адресов и тестовое чтение ускорения в Serial
2026-08-27 Добавлена строгая защита от NaN/Inf в ImuEngine и BleEngine, живой вывод перегрузок X/Y/Z в диагностику
2026-08-27 Установлен MTU 517 и добавлено чанкирование BLE пакетов по 100 байт для гарантированной доставки JSON в браузер
2026-08-27 Рефакторинг интерфейса, переход на режим Готов к старту, исправление созвездий GPS и графики в истории
    [GpsEngine.cpp, TelemetryEngine.cpp, Types.h]
2026-08-27 Добавление поддержки PWA с офлайн-режимом и мгновенным автообновлением по воздуху
2026-08-27 Унификация стиля кнопки BLE подключения под виджеты батареи и сигнала
2026-08-27 Исправление переноса строки в баннере режима гонки и добавление валидации GPS при взведении
    [DRAGon.ino]
2026-08-27 Обновлен дизайн иконки приложения: минималистичный стиль с логотипом RM, шкалой спидометра и плашкой 0-100
2026-08-27 Переключение адресного RGB светодиода WS2812B на внешний пин GPIO 11
2026-08-27 Добавлена проверка заряда батареи двойным кликом кнопки на светодиоде с настраиваемыми режимами
2026-08-27 Принудительное отключение всех встроенных светодиодов на плате ESP32-S3
2026-08-27 Переназначение пинов: внешний адресный светодиод на GPIO 10, кнопка на GPIO 11
2026-08-27 Голосовой помощник отключен по умолчанию, добавлен выбор нейросетевых голосов и спортивное форматирование отсечек
2026-08-27 Добавлены спортивные звуковые сигналы Dragy (бипы и тоны) и выбор режима уведомлений
2026-08-27 Упрощены названия звуковых режимов: Сигналы, Голосовая озвучка, Сигналы + Голосовая озвучка, Без звука
2026-08-27 Добавлен выбор тембров и стилей озвучки штурмана и расширенное определение речевых пакетов
2026-08-27 Исправлена синхронизация режимов индикации батареи, добавлен моментальный предпросмотр на LED и ускорен опрос кнопки
    [BleEngine.cpp, DRAGon.ino]
2026-08-27 Устранена путаница событий кнопки: добавлен 35мс антидребезг, разделены клики и удержание питания
2026-08-27 Переработана световая индикация: комфортное тусклое свечение, яркие вспышки отсечек и старта, 2 красные вспышки при выключении
2026-08-27 Добавлено подробное руководство пользователя USER_MANUAL.md
2026-08-27 Уточнено описание выключения питания в руководстве пользователя
2026-08-27 Исправлена ошибка компиляции: объявлена переменная RaceState curState
    [DRAGon.ino]
2026-08-27 Глобальный рефакторинг стабильности: аппаратная защита I2C, статический буфер BLE, оптимизация FreeRTOS и памяти Heap
2026-08-27 Обновлен дизайн иконки: четкий циферблат, красная стрелка тахометра, фоновый флаг финиша и крупная надпись 0-100
2026-08-27 Иконка приложения: короткая стрелка у шкалы направлена вправо-вниз, центр очищен от ступицы
2026-08-27 Иконка приложения: края красной стрелки сделаны мягкими и закругленными
2026-08-27 Новый дизайн иконки: спорткар со скоростными барами телеметрии в фирменных неоновых цветах RaceMetry
2026-08-27 Иконка приложения: точное соответствие геометрии спорткара по референсу образца
2026-08-27 Иконка приложения перерисована заново: 100% соответствие оригинальному образцу спорткара
2026-08-27 Утвержден и установлен Концепт 2: неон-синтвейв стиль с кибер-спидометром и спорткаром
2026-08-27 Калибровка замера АКБ: уточнен коэффициент делителя (2.024) и порог 100% (4.18В)
2026-08-27 Устранена задержка первого BLE-подключения: быстрый интервал рекламы 20мс, сброс сессии при перезагрузке страницы и надежные повторы GATT
2026-08-27 Устранена проблема холодного старта BLE: разделены пакеты рекламы, мощность передатчика +9dBm, сброс дескриптора GATT 133 при повторах
2026-08-27 Устранена причина задержки подключения: внедрен Network-First в Service Worker (v4.0), устранены коллизии рекламы в ESP32 и оптимизирован поиск BLE
2026-08-28 Реализация 8 улучшений по тестам: часовые пояса, динамический RSSI, сглаживание АКБ, фиксация статус-бара, очистка имен модулей, гараж авто, удаленное выключение и главный последний заезд
2026-08-28 Исправление компиляции в Arduino IDE: удален платформозависимый заголовок esp_gap_ble_api.h
    [BleEngine.cpp, BleEngine.h]
2026-08-29 Рефакторинг измерительного ядра, FreeRTOS очередей, хранилища NVS и Web PWA
2026-08-29 Исправление проверки WHO_AM_I акселерометра для поддержки чипов с ID 0x75
    [ImuEngine.cpp]
2026-08-29 Исправление первого BLE-подключения в PWA
    [BleEngine.cpp, BleEngine.h, DRAGon.ino]
2026-08-29 Устранение гонки BLE: двусторонний handshake (ping/pong), динамический MTU и блокировка телеметрии до подтверждения
2026-08-31 Переход на питание MH-CD42 (5V Boost + Li-Ion) и переименование скетча в RaceMetry
2026-08-31 Переназначение пинов шины I2C для акселерометра MPU-9250 (SCL->13, SDA->12)
2026-08-31 Улучшенная диагностика и отказоустойчивое автоопределение акселерометра MPU на I2C
2026-08-31 Улучшенная обработка команд BLE в веб-приложении и скоростной опрос акселерометра
2026-08-31 Устранение блокировки BLE телеметрии и исправление переполнения списка часовых поясов
    [BleEngine.cpp, RaceMetry.ino]
2026-08-31 Адаптивная верстка выпадающих списков настроек с защитой от вылета за экран
2026-08-31 Перенос RGB светодиодной индикации на встроенный светодиод платы (GPIO 48)
2026-08-31 Универсальная поддержка всех встроенных RGB и монохромных светодиодов ESP32-S3
2026-08-31 Назначение адресного светодиода только на GPIO 21
2026-08-31 Реализация системы профилей авто (Гараж) и модального селектора часового пояса
2026-08-31 Сброс кэша PWA Service Worker (v5.0) и добавление кнопки принудительного обновления
2026-08-31 Исправление отображения модальных окон Гаража и селектора часового пояса
2026-08-31 Исправление z-index формы добавления авто и надежная логика удаления из гаража
2026-09-05 Исправление отображения данных замера в карточке Последний заезд и удаление пометки главный
2026-09-05 Удаление верхнего фильтра авто с кнопкой Гараж, иконки огонька и блока Рекорды авто во вкладке История
2026-09-05 Удаление фильтра заездов по автомобилю во вкладке История и прямой показ всех заездов
2026-09-05 Привязка истории заездов строго к карточке выбранного автомобиля
2026-09-05 Удаление лишней кнопки автомобиля из заголовка Последний заезд в Истории
2026-09-05 Реорганизация шапки: шкала спутников, вынос RaceMetry на строку 2 и адаптация экрана под один экран без скролла
2026-09-05 Устранение черного поля снизу, возврат полноразмерного интерфейса и блокировка скролла экрана Cockpit
